ttahsin-bey/xlink-smt/README.md

# xlink-smt
Hardware compatible to xlink-project from Henning Bekel: http://henning-bekel.de/xlink/
