ttahsin-bey/xlink-smt/Circuit Diagram - xlink-smt.pdf

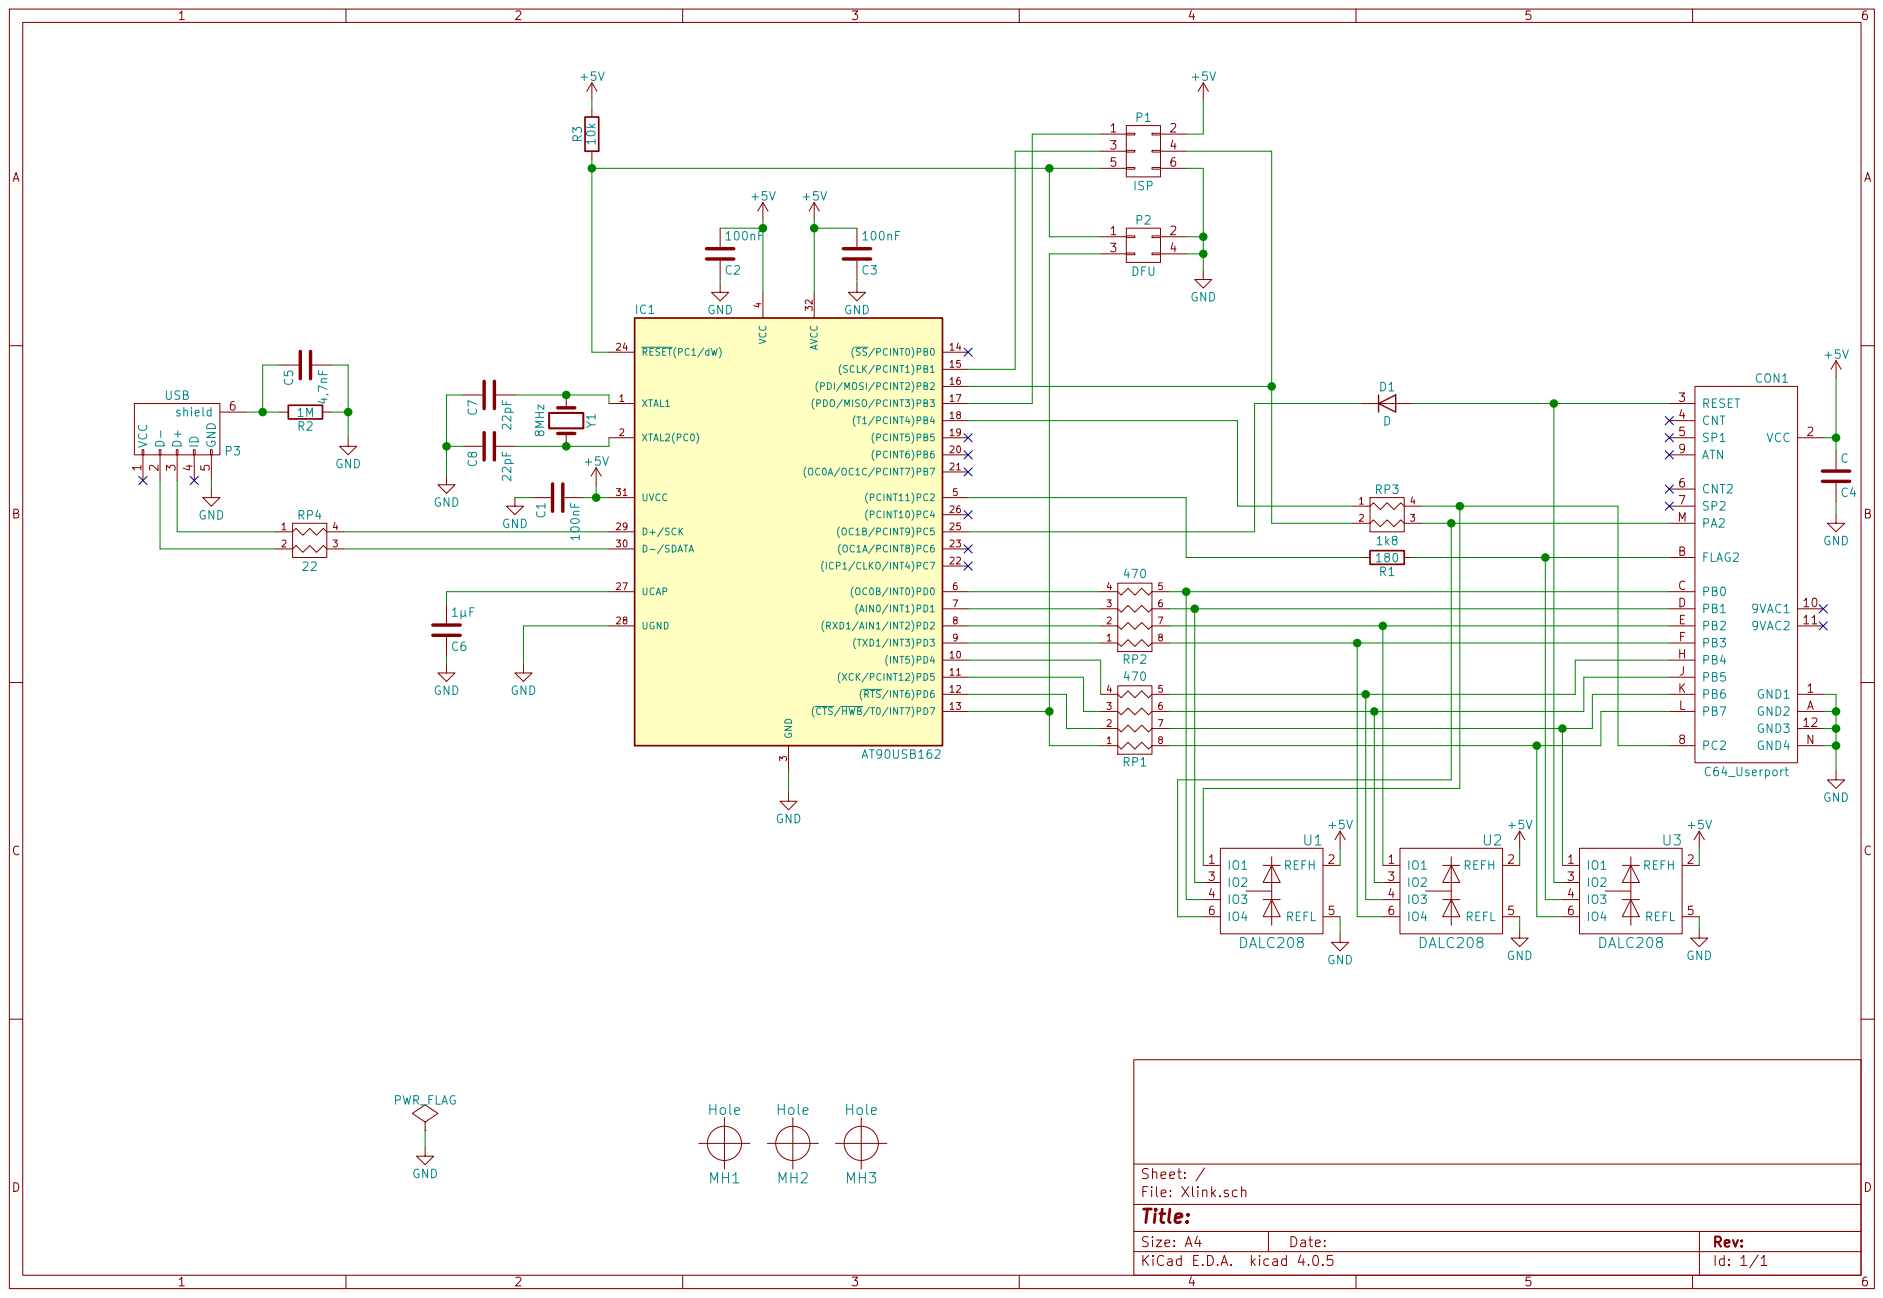
[picture p1: page 1]

PB7 L PA2 M FLAG2 B PB0 C

3 | 6 | | PB1 D
2 | 7 | | PB2 E
1 | | | | PB3 F PB4 H
