ttahsin-bey/xlink-smt/KiCad/Xlink.kicad_pcb

## KiCad design KiCad/Xlink.kicad_pcb (2017-09-23)

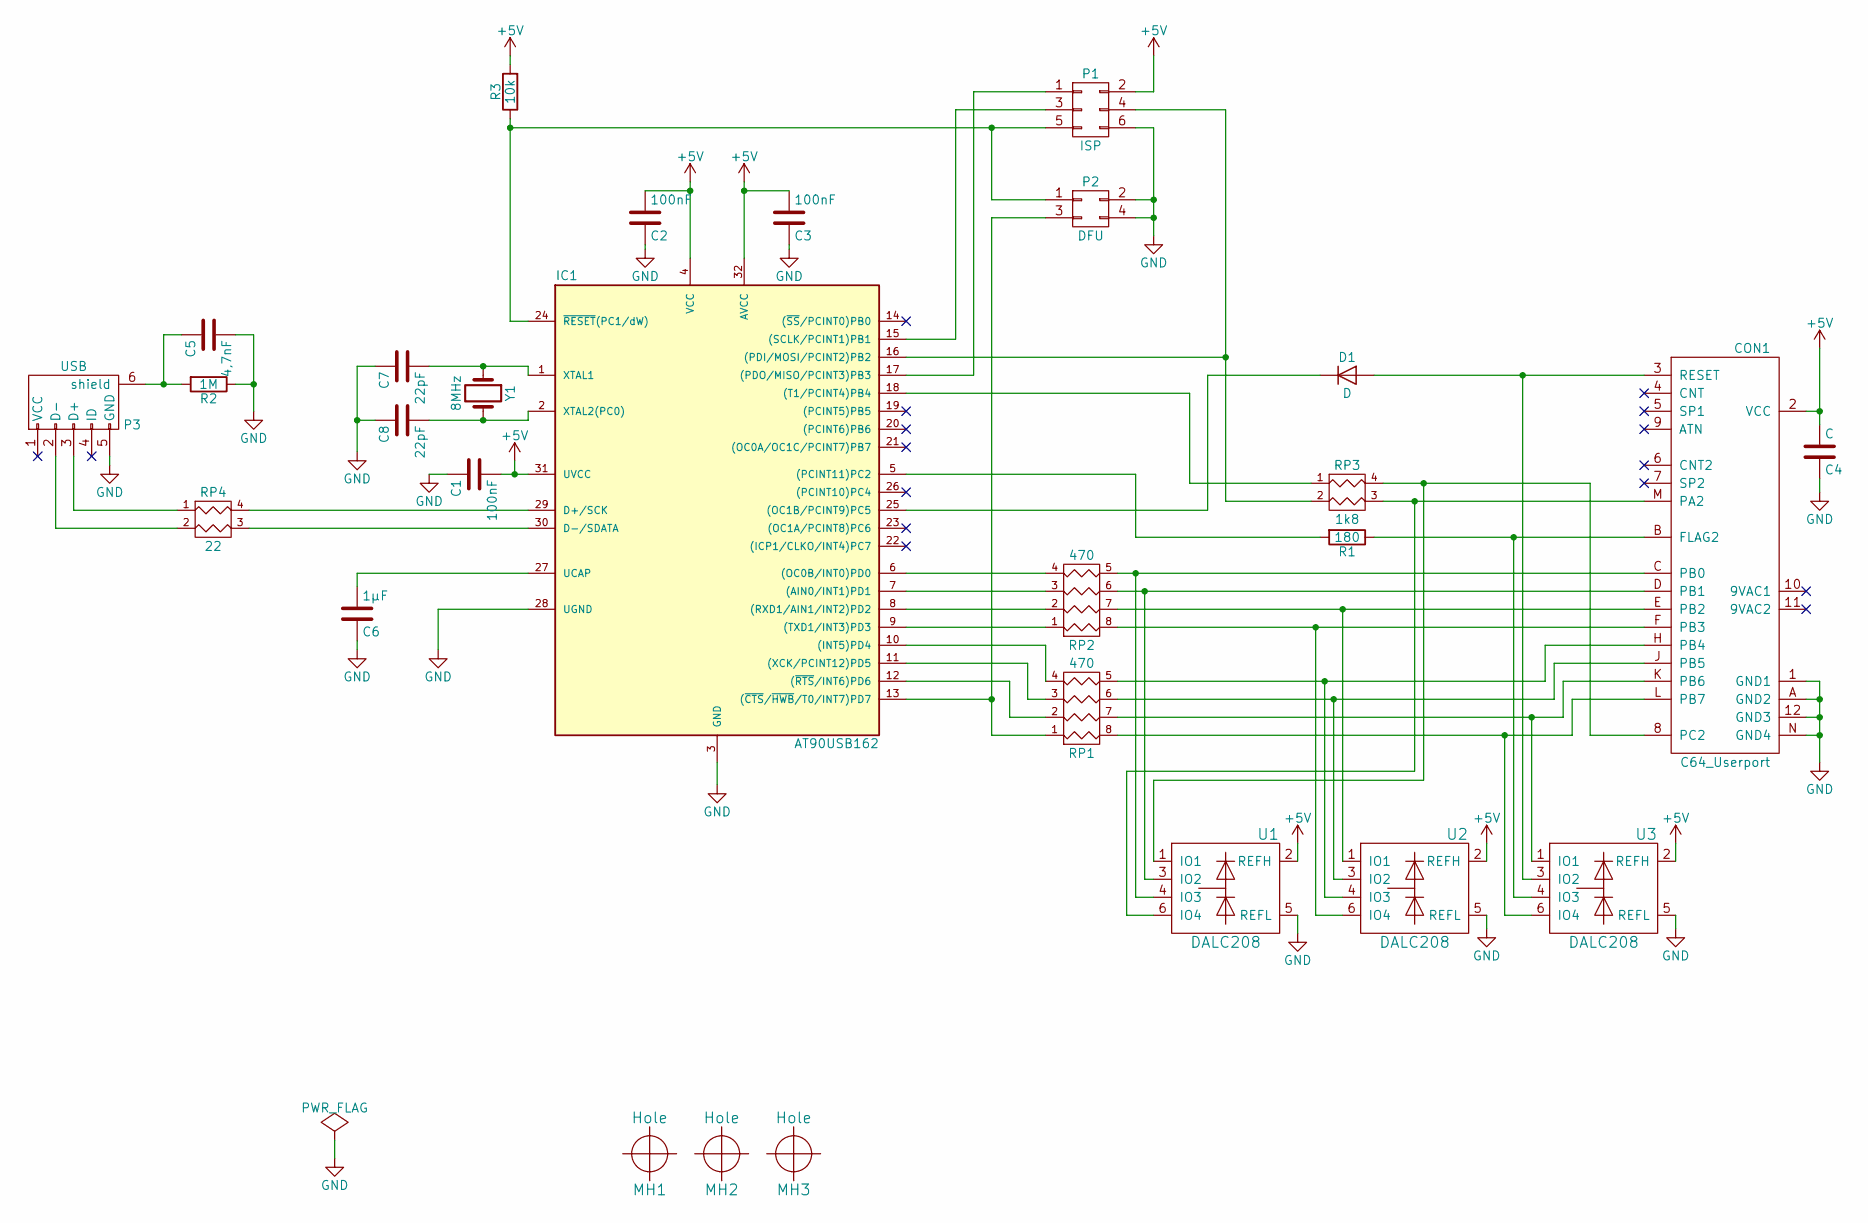
[picture p2: schematic Xlink.sch]

Parts:
C1, C2, C3: 100nF; TTB_C0603
C4: C; TTB_C0603
C5: 4,7nF; TTB_C0603
C6: 1µF; TTB_C0805
C7, C8: 22pF; TTB_C0603wide
CON1: C64_Userport; TTB_C64_Userport
D1: D; TTB_D0603
IC1: AT90USB162; TTB_TQFP32
MH1, MH2, MH3: Hole; MountingHole_3mm
P1: ISP; TTB_Pinhead_2x3
P2: DFU; TTB_Pinhead_2x2
P3: USB; TTB_USB-B_Micro_Würth
R1: 180; TTB_R0603
R2: 1M; TTB_R0603
R3: 10k; TTB_R0603
RP1, RP2: 470; TTB_RNet1206_4R
RP3: 1k8; TTB_RNet1206_2R
RP4: 22; TTB_RNet1206_2R
U1, U2, U3: DALC208; TTB_SOT23-6L
Y1: 8MHz; TTB_7A

Connections:
+5V: C1.2, C2.2, C3.2, C4.2, CON1.2 (VCC), IC1.4 (VCC), IC1.31 (UVCC), IC1.32 (AVCC), P1.2, R3.2, U1.2 (REFH), U2.2 (REFH), U3.2 (REFH)
GND: C1.1, C2.1, C3.1, C4.1, C5.2, C6.1, C7.1, C8.1, CON1.1 (GND1), CON1.12 (GND3), CON1.A (GND2), CON1.N (GND4), IC1.3 (GND), IC1.28 (UGND), P1.6, P2.2, P2.4, P3.5 (GND), R2.1, U1.5 (REFL), U2.5 (REFL), U3.5 (REFL)
unnamed: C5.1, P3.6 (shield), R2.2
unnamed: C6.2, IC1.27 (UCAP)
unnamed: C7.2, IC1.1 (XTAL1), Y1.1
unnamed: C8.2, IC1.2 (XTAL2(PC0)), Y1.2
unnamed: CON1.3 (RESET), D1.2 (A), U3.3 (IO2)
unnamed: CON1.8 (PC2), RP3.4 (R1), U1.1 (IO1)
unnamed: CON1.B (FLAG2), R1.1, U3.4 (IO3)
unnamed: CON1.C (PB0), RP2.5 (R4), U1.4 (IO3)
unnamed: CON1.D (PB1), RP2.6 (R3), U1.3 (IO2)
unnamed: CON1.E (PB2), RP2.7 (R2), U2.1 (IO1)
unnamed: CON1.F (PB3), RP2.8 (R1), U2.6 (IO4)
unnamed: CON1.H (PB4), RP1.5 (R4), U2.4 (IO3)
unnamed: CON1.J (PB5), RP1.6 (R3), U2.3 (IO2)
unnamed: CON1.K (PB6), RP1.7 (R2), U3.1 (IO1)
unnamed: CON1.L (PB7), RP1.8 (R1), U3.6 (IO4)
unnamed: CON1.M (PA2), RP3.3 (R2), U1.6 (IO4)
unnamed: D1.1 (K), IC1.25 ((OC1B/PCINT9)PC5)
unnamed: IC1.5 ((PCINT11)PC2), R1.2
unnamed: IC1.6 ((OC0B/INT0)PD0), RP2.4
unnamed: IC1.7 ((AIN0/INT1)PD1), RP2.3
unnamed: IC1.8 ((RXD1/AIN1/INT2)PD2), RP2.2
unnamed: IC1.9 ((TXD1/INT3)PD3), RP2.1
unnamed: IC1.10 ((INT5)PD4), RP1.4
unnamed: IC1.11 ((XCK/PCINT12)PD5), RP1.3
unnamed: IC1.12 ((~RTS~/INT6)PD6), RP1.2
unnamed: IC1.13 ((~CTS~/~HWB~/T0/INT7)PD7), P2.3, RP1.1
unnamed: IC1.15 ((SCLK/PCINT1)PB1), P1.3
unnamed: IC1.16 ((PDI/MOSI/PCINT2)PB2), P1.4, RP3.2
unnamed: IC1.17 ((PDO/MISO/PCINT3)PB3), P1.1
unnamed: IC1.18 ((T1/PCINT4)PB4), RP3.1
unnamed: IC1.24 (~RESET~(PC1/dW)), P1.5, P2.1, R3.1
unnamed: IC1.29 (D+/SCK), RP4.4 (R1)
unnamed: IC1.30 (D-/SDATA), RP4.3 (R2)
unnamed: P3.2 (D-), RP4.2
unnamed: P3.3 (D+), RP4.1

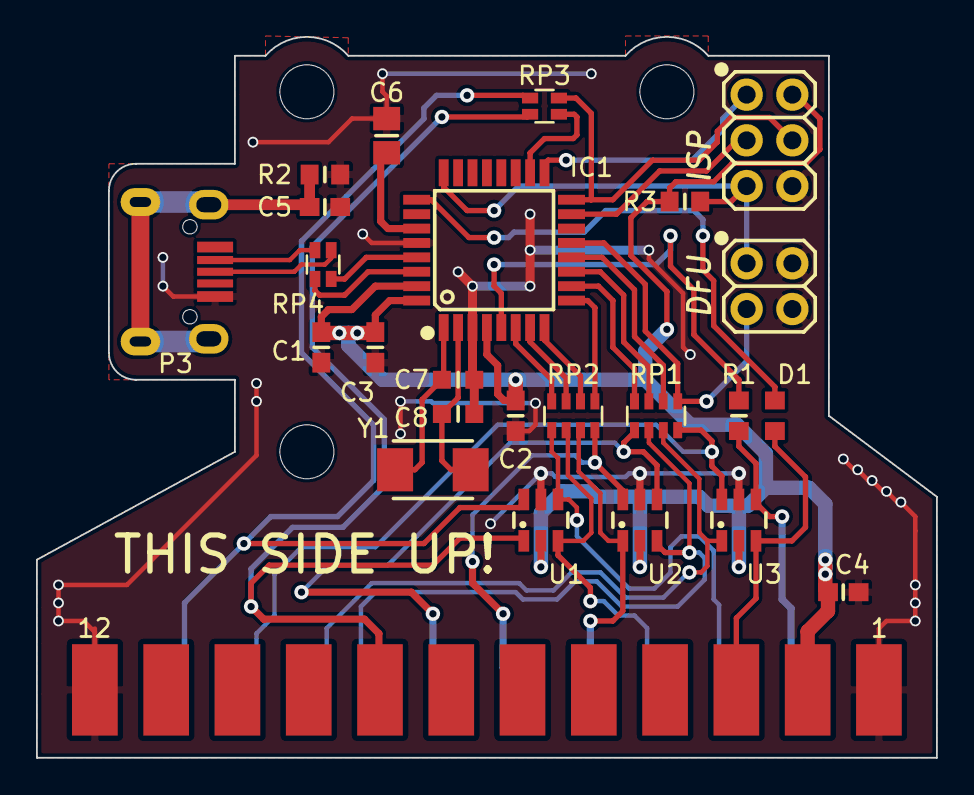
[picture p3: board Xlink.kicad_pcb from above]

Board: 2 copper layers, 50.0 x 40.0 mm, 28 parts (0 on the bottom side), 37 nets.
